Bryce-AC/AUMT-Temp-Sense/README.md

# AUMT Temp Sense
 Tyre temperature monitoring sensors/arduino projcet
