Bryce-AC/AUMT-Temp-Sense/pcb/revision notes.txt

Notes for tyre temp board

- increase sizing for CAN termination resistor
	- use throughhole part (don't need to populate)

- rearrange CAN section to minimise distance from controller to Arduino

- try to minimise loops
