Bryce-AC/AUMT-Temp-Sense/(list of files, cad)

Other CAD files:
pcb/pcb.SLDPRT
