Bryce-AC/AUMT-Temp-Sense/pcb/tyre_temp_sense/tyre_temp_sense.pdf

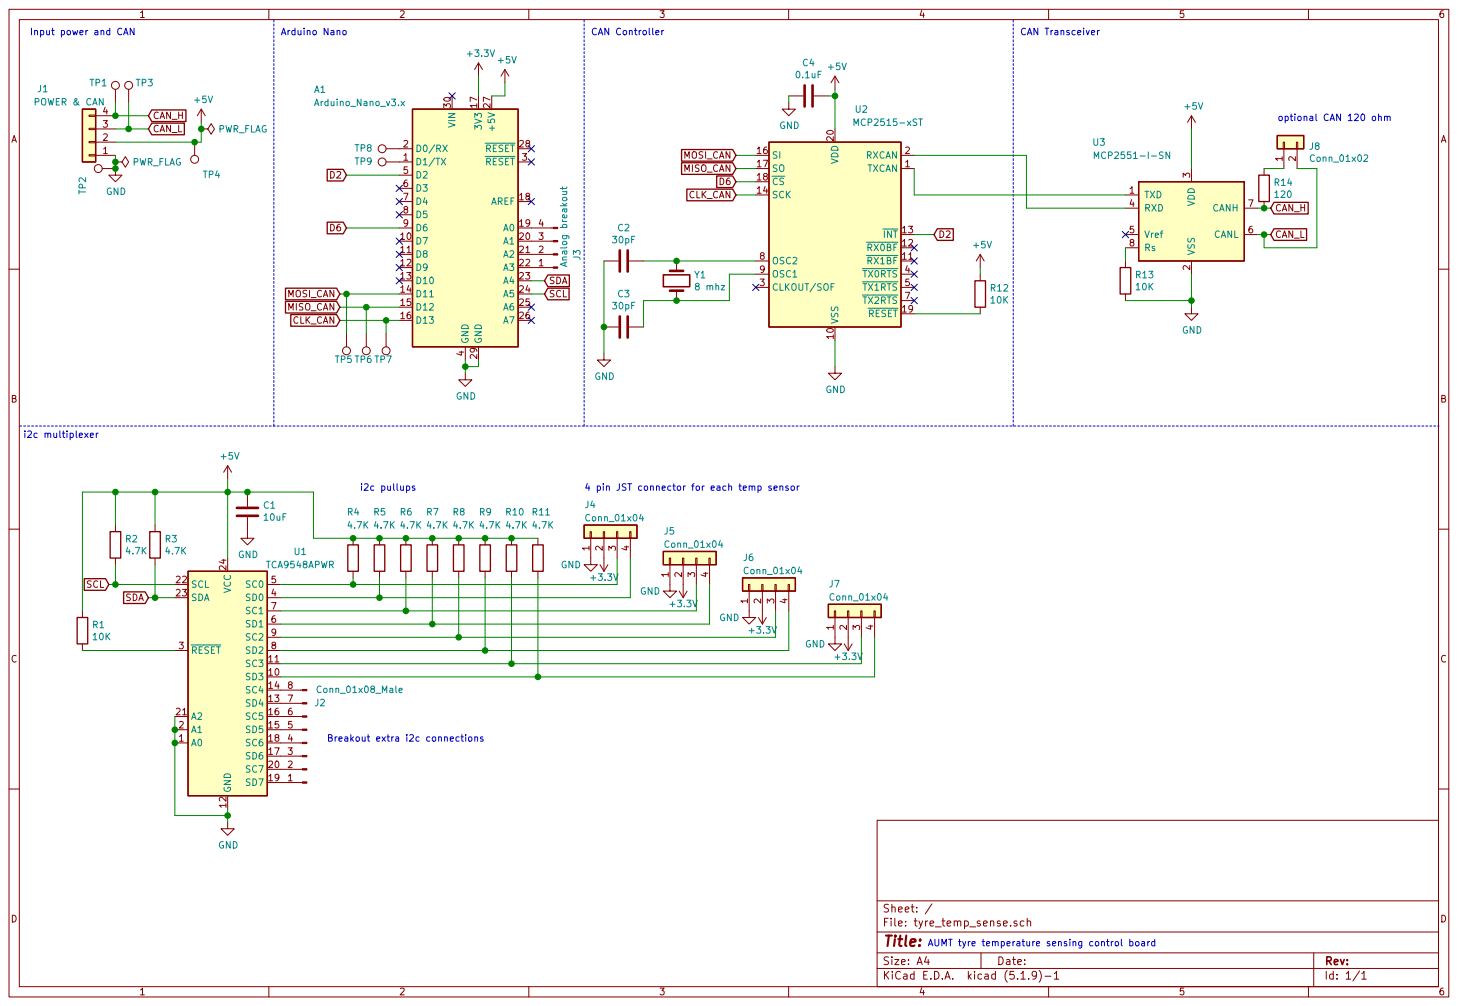
[picture p1: page 1]

3 RXD 4 Vref 5 CANL 6 CANH 7 Rs 8 U3MCP2551-I-SN

4 pin JST connector for each temp sensor
