Bryce-AC/AUMT-Temp-Sense/pcb/tyre_temp_sense/tyre_temp_sense.kicad_pcb

## KiCad design pcb/tyre_temp_sense/tyre_temp_sense.kicad_pcb (2021-08-03)

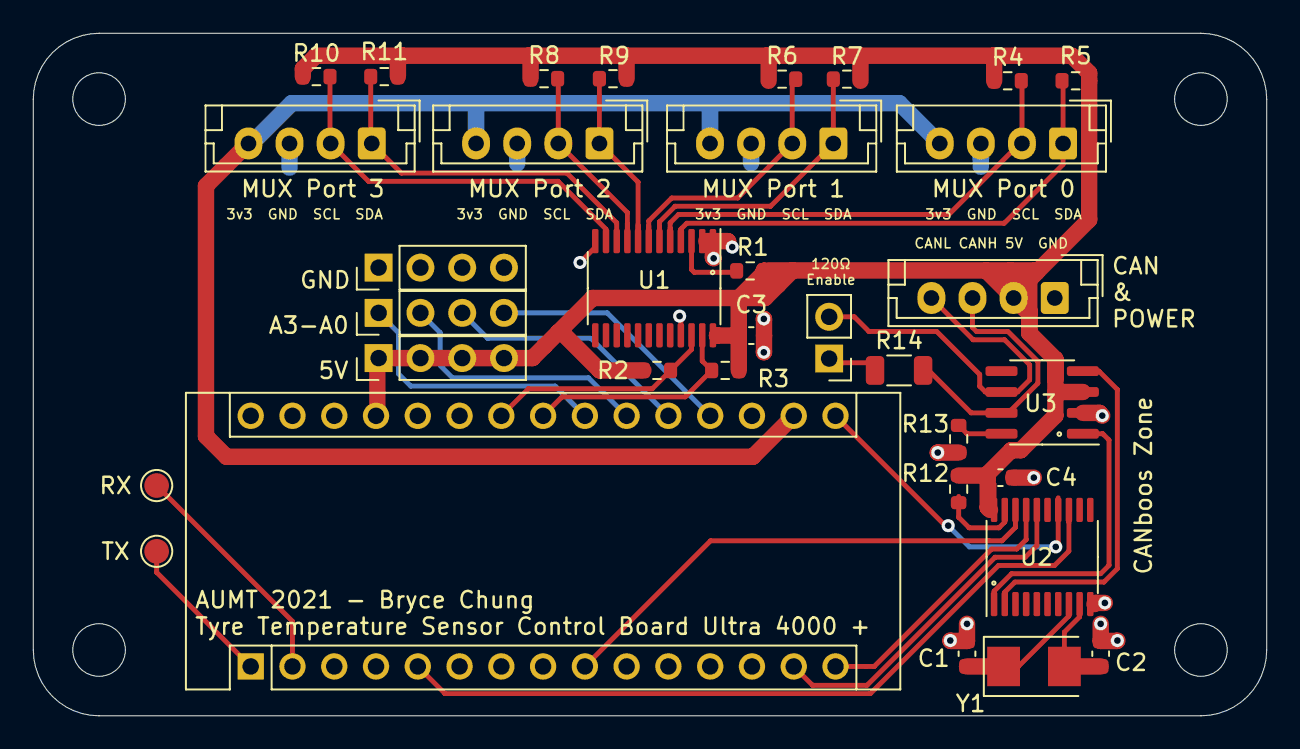
[picture p2: board tyre_temp_sense.kicad_pcb from above]

Board: 2 copper layers, 75.0 x 41.5 mm, 34 parts (0 on the bottom side), 34 nets.

Parts:
A1: Arduino_Nano_v3.x; Arduino_Nano
C1, C2: 30pF; C_0603_1608Metric
C3: 10uF; C_0603_1608Metric
C4: 1uF; C_0603_1608Metric
J1: POWER & CAN; JST_EH_B4B-EH-A_1x04_P2.50mm_Vertical
J2: MUX Port 0; JST_EH_B4B-EH-A_1x04_P2.50mm_Vertical
J3: MUX Port 1; JST_EH_B4B-EH-A_1x04_P2.50mm_Vertical
J4: MUX Port 2; JST_EH_B4B-EH-A_1x04_P2.50mm_Vertical
J5: MUX Port 3; JST_EH_B4B-EH-A_1x04_P2.50mm_Vertical
J6: Conn_01x02; PinHeader_1x02_P2.54mm_Vertical
J7: A; PinHeader_1x04_P2.54mm_Vertical
J8, J9: GND; PinHeader_1x04_P2.54mm_Vertical
R1, R12, R13: 10K; R_0603_1608Metric
R2, R3, R4, R5, R6, R7, R8, R9, R10, R11: 4.7K; R_0603_1608Metric
R14: 120; R_1206_3216Metric
TP8: RX; TestPoint_Pad_D1.5mm
TP9: TX; TestPoint_Pad_D1.5mm
U1: TCA9548APWR; TSSOP-24_4.4x7.8mm_P0.65mm
U2: MCP2515-I/ST; TSSOP-20_4.4x6.5mm_P0.65mm
U3: MCP2551-I-SN; SOIC-8_3.9x4.9mm_P1.27mm
Y1: 8 mhz; Crystal_SMD_5032-2Pin_5.0x3.2mm

Connections:
+3V3: A1.17, J2.4, J3.4, J4.4, J5.4
+5V: A1.27, C3.2, C4.1, J1.2, J9.1, J9.2, J9.3, J9.4, R1.1, R2.1, R3.1, R4.1, R5.1, R6.1, R7.1, R8.1, R9.1, R10.1, R11.1, R12.1, U1.24, U2.20, U3.3
A0: A1.19, J7.4
A1: A1.20, J7.3
A2: A1.21, J7.2
A3: A1.22, J7.1
CAN+: J1.3, R14.2, U3.7
CAN-: J1.4, J6.2, U3.6
CLK_CAN: A1.16, U2.14
D2: A1.5, U2.13
D6: A1.9, U2.18
GND: A1.4, A1.29, C1.2, C2.2, C3.1, C4.2, J1.1, J2.3, J3.3, J4.3, J5.3, J8.1, J8.2, J8.3, J8.4, R13.2, U1.1, U1.2, U1.12, U1.21, U2.10, U3.2
MISO_CAN: A1.15, U2.17
MOSI_CAN: A1.14, U2.16
unnamed: A1.1, TP9.1
unnamed: A1.2, TP8.1
unnamed: C1.1, U2.8, Y1.1
unnamed: C2.1, U2.9, Y1.2
unnamed: J2.1, R5.2, U1.4
unnamed: J2.2, R4.2, U1.5
unnamed: J3.1, R7.2, U1.6
unnamed: J3.2, R6.2, U1.7
unnamed: J4.1, R9.2, U1.8
unnamed: J4.2, R8.2, U1.9
unnamed: J5.1, R11.2, U1.10
unnamed: J5.2, R10.2, U1.11
unnamed: J6.1, R14.1
unnamed: R1.2, U1.3
unnamed: R12.2, U2.19
unnamed: R13.1, U3.8
unnamed: U2.1, U3.1
unnamed: U2.2, U3.4
SCL: A1.24, R2.2, U1.22
SDA: A1.23, R3.2, U1.23
