Bryce-AC/AUMT-Temp-Sense/(commit log)

2021-07-19 Added sensor methods
    get_temp and print_temp
    both take a mux port and array pointer
2021-07-28 Schematic complete, starting PCB
    [tyre_temp_sense.kicad_pcb, tyre_temp_sense.sch]
2021-07-30 PCB design complete
    [tyre_temp_sense.kicad_pcb, tyre_temp_sense.sch]
2021-07-30 First revision, ready for production
    Added JLCPCB parts
    [TTS_PCB.kicad_pcb, TTS_PCB.sch, tyre_temp_sense(with mounts).kicad_pcb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]
2021-07-31 rev 1
    [tyre_temp_sense(with mounts).kicad_pcb, tyre_temp_sense.kicad_pcb]
2021-07-31 First revision, ready for production
    Revert "rev 1"
    This reverts commit d7fe8d90d780ed24d08af68c791964fcba5617af.
    Revert "Revert "rev 1""
    This reverts commit 5d4b21aec522fc29a8afe0da54f0448a4a3d7d19.
    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
    [TTS_PCB.kicad_pcb, TTS_PCB.sch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]
2021-07-31 Revert "rev 1"
    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
    [tyre_temp_sense(with mounts).kicad_pcb]
2021-07-31 revision 2
    [TTS_PCB.kicad_pcb, TTS_PCB.sch, tyre_temp_sense(with mounts).kicad_pcb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]
2021-07-31 Second revision
    [tyre_temp_sense.kicad_pcb, tyre_temp_sense.sch]
2021-07-31 Added LCSC Part info
    [tyre_temp_sense.kicad_pcb, tyre_temp_sense.sch]
2021-08-01 Gerbers, drill, BOM and part pos added
    [tyre_temp_sense-B_Cu.gbr, tyre_temp_sense-B_Mask.gbr, tyre_temp_sense-B_Paste.gbr, tyre_temp_sense-B_SilkS.gbr, tyre_temp_sense-Edge_Cuts.gbr, tyre_temp_sense-F_Cu.gbr, tyre_temp_sense-F_Mask.gbr, tyre_temp_sense-F_Paste.gbr]
2021-08-03 Added test code
    Can send the temp sensor data directly to dash
2021-08-30 code dump
    breadboard sandpit included for fixing the data weird data transmission
    [MLX90621.cpp, MLX90621.h, breadboard_sandpit.ino, can_recv_test.ino, temp_sense_to_dash.ino]
2021-09-01 added drivers and float code
